ikesato/esp-temperature-thingspeak/eagle/espr-temp.brd

## EAGLE design eagle/espr-temp.brd (2018-05-30)

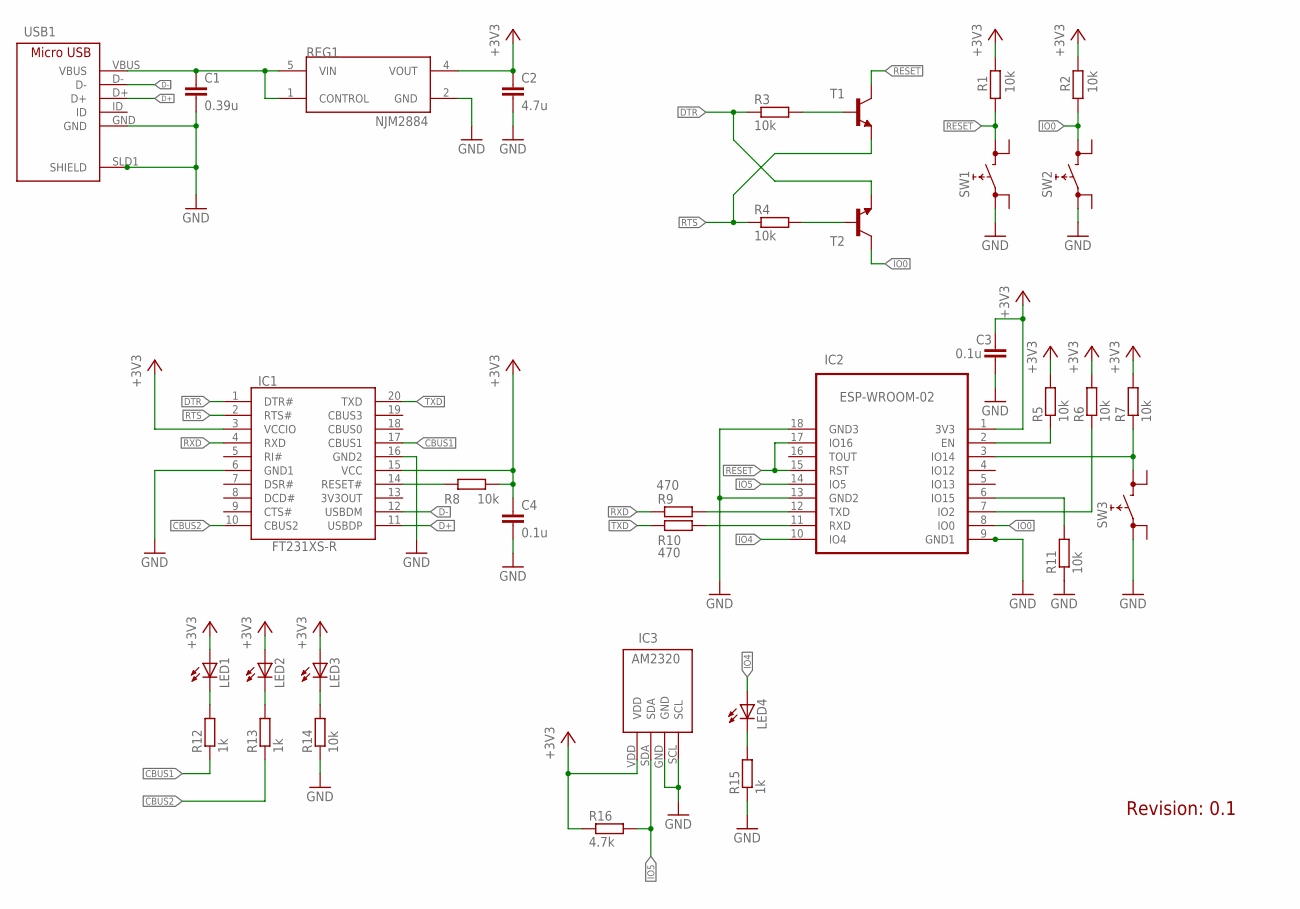
[picture p1: schematic espr-temp.sch]

Parts:
C1: 0.39u; C1608
C2: 4.7u; C3216
C3, C4: 0.1u; C2012
IC1: FT231XS-R; SOP64P599X175-20N
IC2: ESP-WROOM-02
IC3: AM2320
LED1: OSHR1608; C1608
LED2: OSYG1608; C1608
LED3: OSYL1608; C1608
LED4: OSBL1608; C1608
R1, R2, R3, R4, R5, R6, R7, R8, R11, R14: 10k; R1608
R9, R10: 470; R1608
R12, R13, R15: 1k; R1608
R16: 4.7k; M0805
REG1: NJM2884; NJM2884-SOT-89-5
SW1, SW2, SW3: SKRPACE010
T1, T2: 2PD601A; SOT346
USB1: MICRO-USB; ZX62B5PA

Connections:
+3V3: C2.1, C3.1, C4.1, IC1.3 (VCCIO), IC1.15 (VCC), IC2.1 (3V3), IC3.VDD, LED1.A, LED2.A, LED3.A, R1.2, R2.2, R5.2, R6.2, R7.2, R8.2, R16.1, REG1.4 (VOUT)
CBUS1: IC1.17 (CBUS1), R12.1
CBUS2: IC1.10 (CBUS2), R13.1
D+: IC1.11 (USBDP), USB1.D+
D-: IC1.12 (USBDM), USB1.D-
DTR: IC1.1 (DTR#), R3.1, T2.2 (E)
GND: C1.2, C2.2, C3.2, C4.2, IC1.6 (GND1), IC1.16 (GND2), IC2.9 (GND1), IC2.13 (GND2), IC2.18 (GND3), IC2.19 (GND0), IC3.GND, IC3.SCL, R11.1, R14.1, R15.1, REG1.2 (GND), SW1.1 (0), SW2.1 (0), SW3.1 (0), USB1.GND, USB1.SLD1 (SHIELD), USB1.SLD2 (SHIELD2), USB1.SLD3 (SHIELD3), USB1.SLD4 (SHIELD4), USB1.SLD5 (SHIELD5), USB1.SLD6 (SHIELD6)
IO0: IC2.8 (IO0), R2.1, SW2.3 (1), T2.3 (C)
IO4: IC2.10 (IO4), LED4.A
IO5: IC2.14 (IO5), IC3.SDA, R16.2
unnamed: IC2.2 (EN), R5.1
unnamed: LED4.C, R15.2
unnamed: IC2.7 (IO2), R6.1
unnamed: C1.1, REG1.1 (CONTROL), REG1.5 (VIN), USB1.VBUS
unnamed: LED1.C, R12.2
unnamed: R3.2, T1.1 (B)
unnamed: R4.2, T2.1 (B)
unnamed: LED2.C, R13.2
unnamed: LED3.C, R14.2
unnamed: IC2.12 (TXD), R9.2
unnamed: IC2.11 (RXD), R10.2
unnamed: IC2.6 (IO15), R11.2
unnamed: IC1.14 (RESET#), R8.1
unnamed: IC2.3 (IO14), R7.1, SW3.3 (1)
RESET: IC2.15 (RST), IC2.17 (IO16), R1.1, SW1.3 (1), T1.3 (C)
RTS: IC1.2 (RTS#), R4.1, T1.2 (E)
RXD: IC1.4 (RXD), R9.1
TXD: IC1.20 (TXD), R10.1

Notes on the sheet:
Revision: 0.1

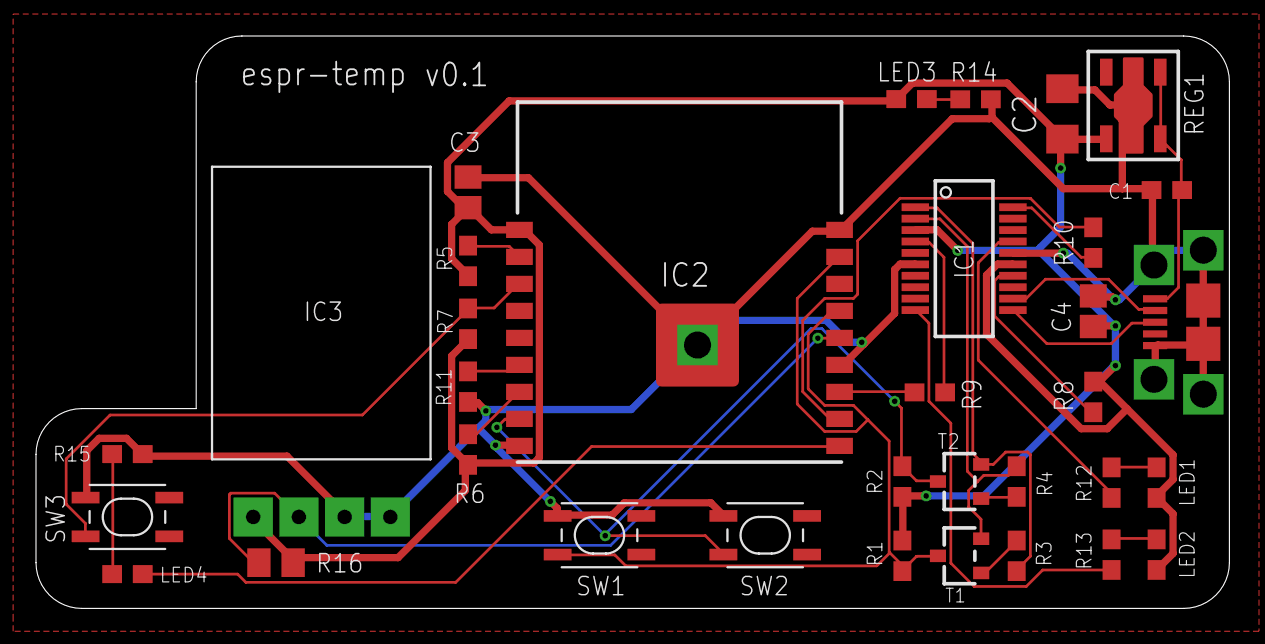
[picture p2: board espr-temp.brd from above]

Board: 2 copper layers, 66.3 x 31.8 mm, 34 parts (0 on the bottom side), 28 nets.
