ikesato/esp-temperature-thingspeak/eagle/esp-temperature.brd

## EAGLE design eagle/esp-temperature.brd (2018-05-14)

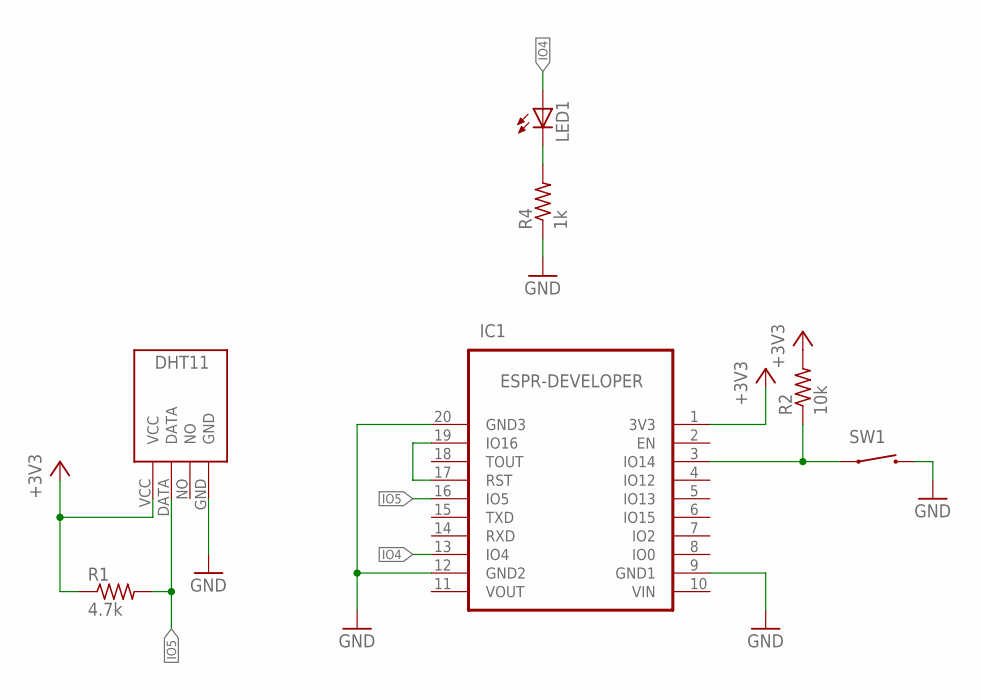
[picture p3: schematic esp-temperature.sch]

Parts:
IC1: ESPR-DEVELOPER
LED1: LED-SIDEUP2; LED5MM-SIDE-UP2
R1: 4.7k; R0805
R2: 10k; R0805
R4: 1k; R0805
SW1: TVBP06
U$1: DHT11

Connections:
+3V3: IC1.1 (3V3), R1.1, R2.2, U$1.VCC
GND: IC1.9 (GND1), IC1.12 (GND2), IC1.20 (GND3), R4.1, SW1.2, U$1.GND
IO4: IC1.13 (IO4), LED1.A
IO5: IC1.16 (IO5), R1.2, U$1.DATA
unnamed: IC1.3 (IO14), R2.1, SW1.1
unnamed: LED1.K (C), R4.2
unnamed: IC1.17 (RST), IC1.19 (IO16)
VIN: IC1.10 (VIN)
VOUT: IC1.11 (VOUT)

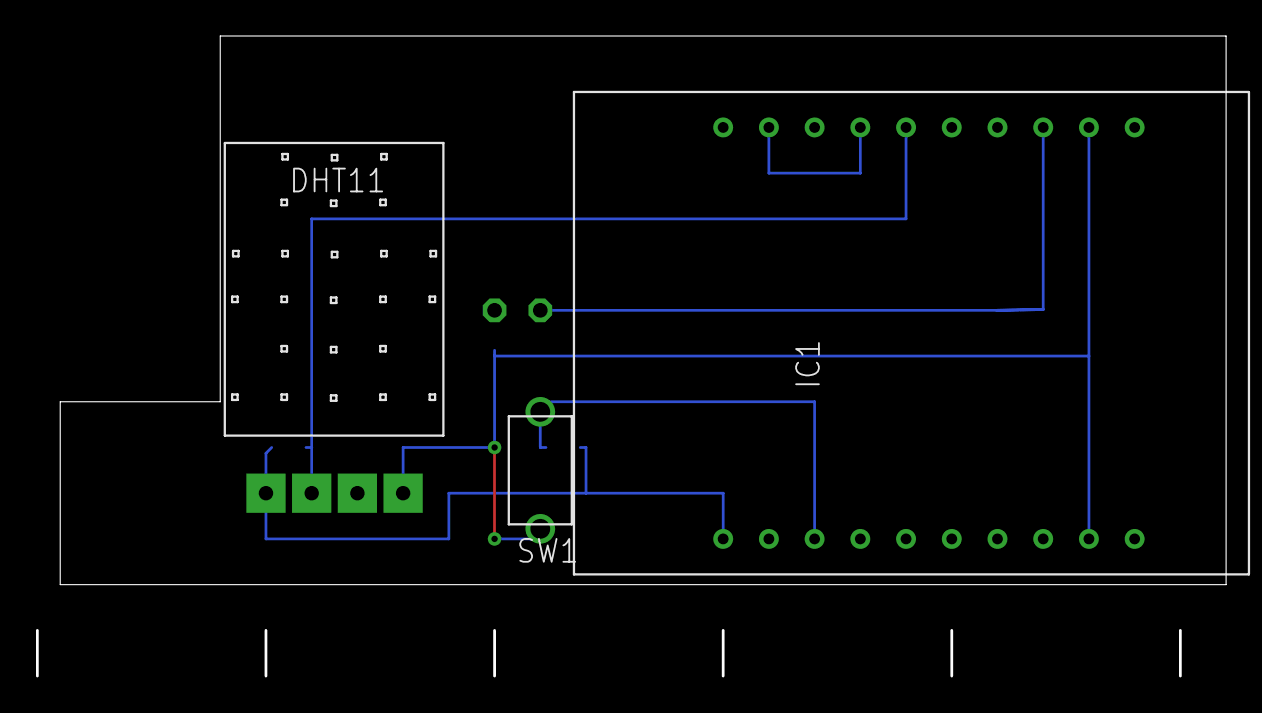
[picture p4: board esp-temperature.brd from above]

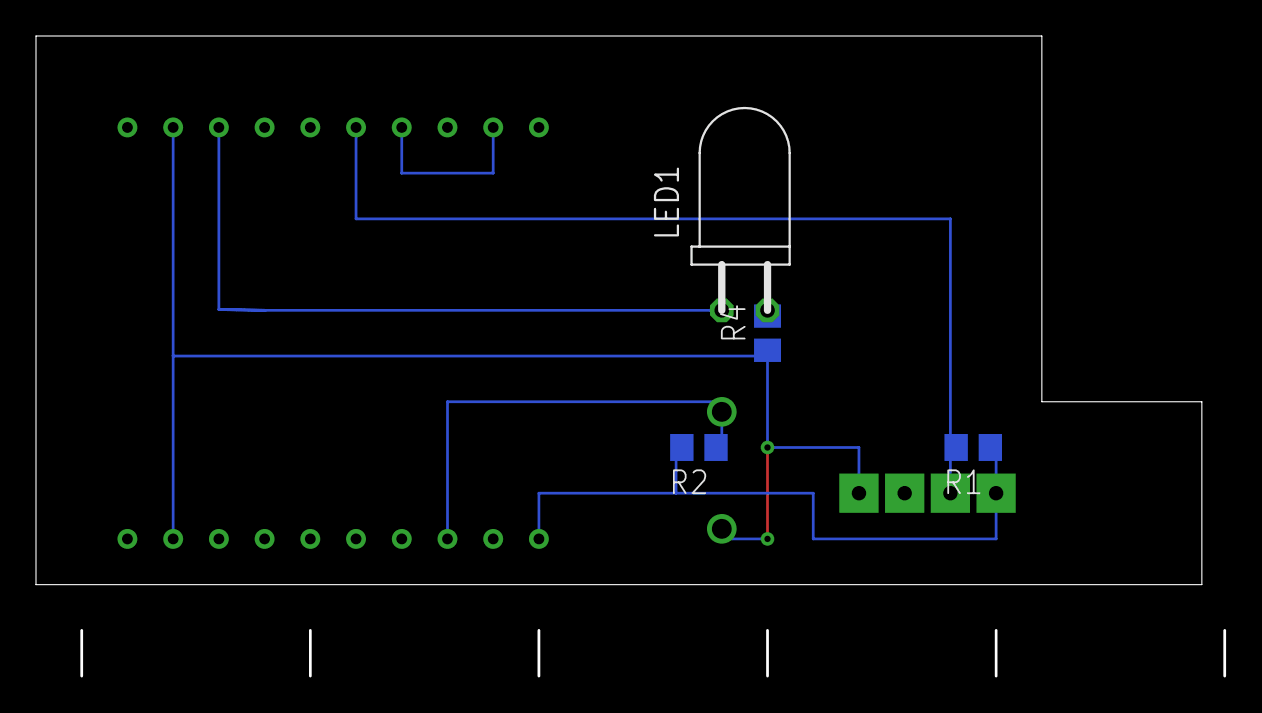
[picture p5: board esp-temperature.brd from below]

Board: 2 copper layers, 64.8 x 30.5 mm, 7 parts (4 on the bottom side), 7 nets.
