ikesato/esp-temperature-thingspeak/(commit log)

2018-05-14 Add eagle files
    [esp-temperature.brd, esp-temperature.sch]
2018-05-21 fix write RTC memory position
    [esp-temperature-thingspeak.ino]
2018-05-21 add AM2320 sensor
2018-05-29 add espr-temp project
    [espr-temp.brd, espr-temp.sch]
2018-05-29 add zip of gerber files for JLCPCB
2018-05-29 moved silk 'REG1' and made the font a little bigger
    [espr-temp.brd]
2018-05-29 fix some ERC errors
    [espr-temp.brd, espr-temp.sch]
2018-05-30 change to GND from tRistrict for WROOM2 library
    [espr-temp.brd, espr-temp.sch]
